mastrogippo/Prism-Test-Board/README.md

# Prism Test Board

[Writeup and pics here]( https://www.mastrogippo.it/2019/09/board-testing-its-fun-they-said/ )
