mastrogippo/Prism-Test-Board/HW/Board_seat.stl

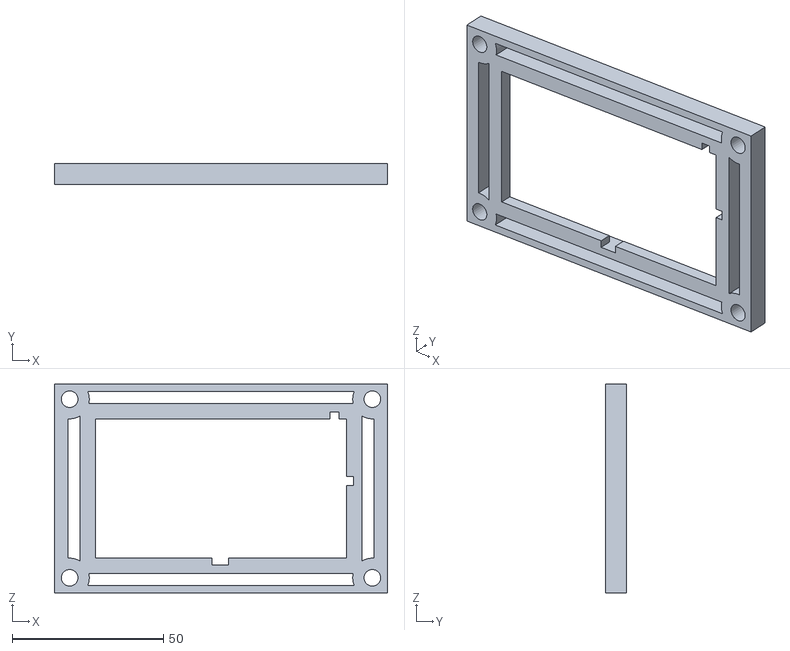
[picture p1: CAD file, 2019-09-27]
HW/Board_seat.stl
110.0 x 7.00 x 69.0
