mastrogippo/Prism-Test-Board/HW/PCB/test_board_logic3.brd

## EAGLE design HW/PCB/test_board_logic3.brd (2019-09-27)

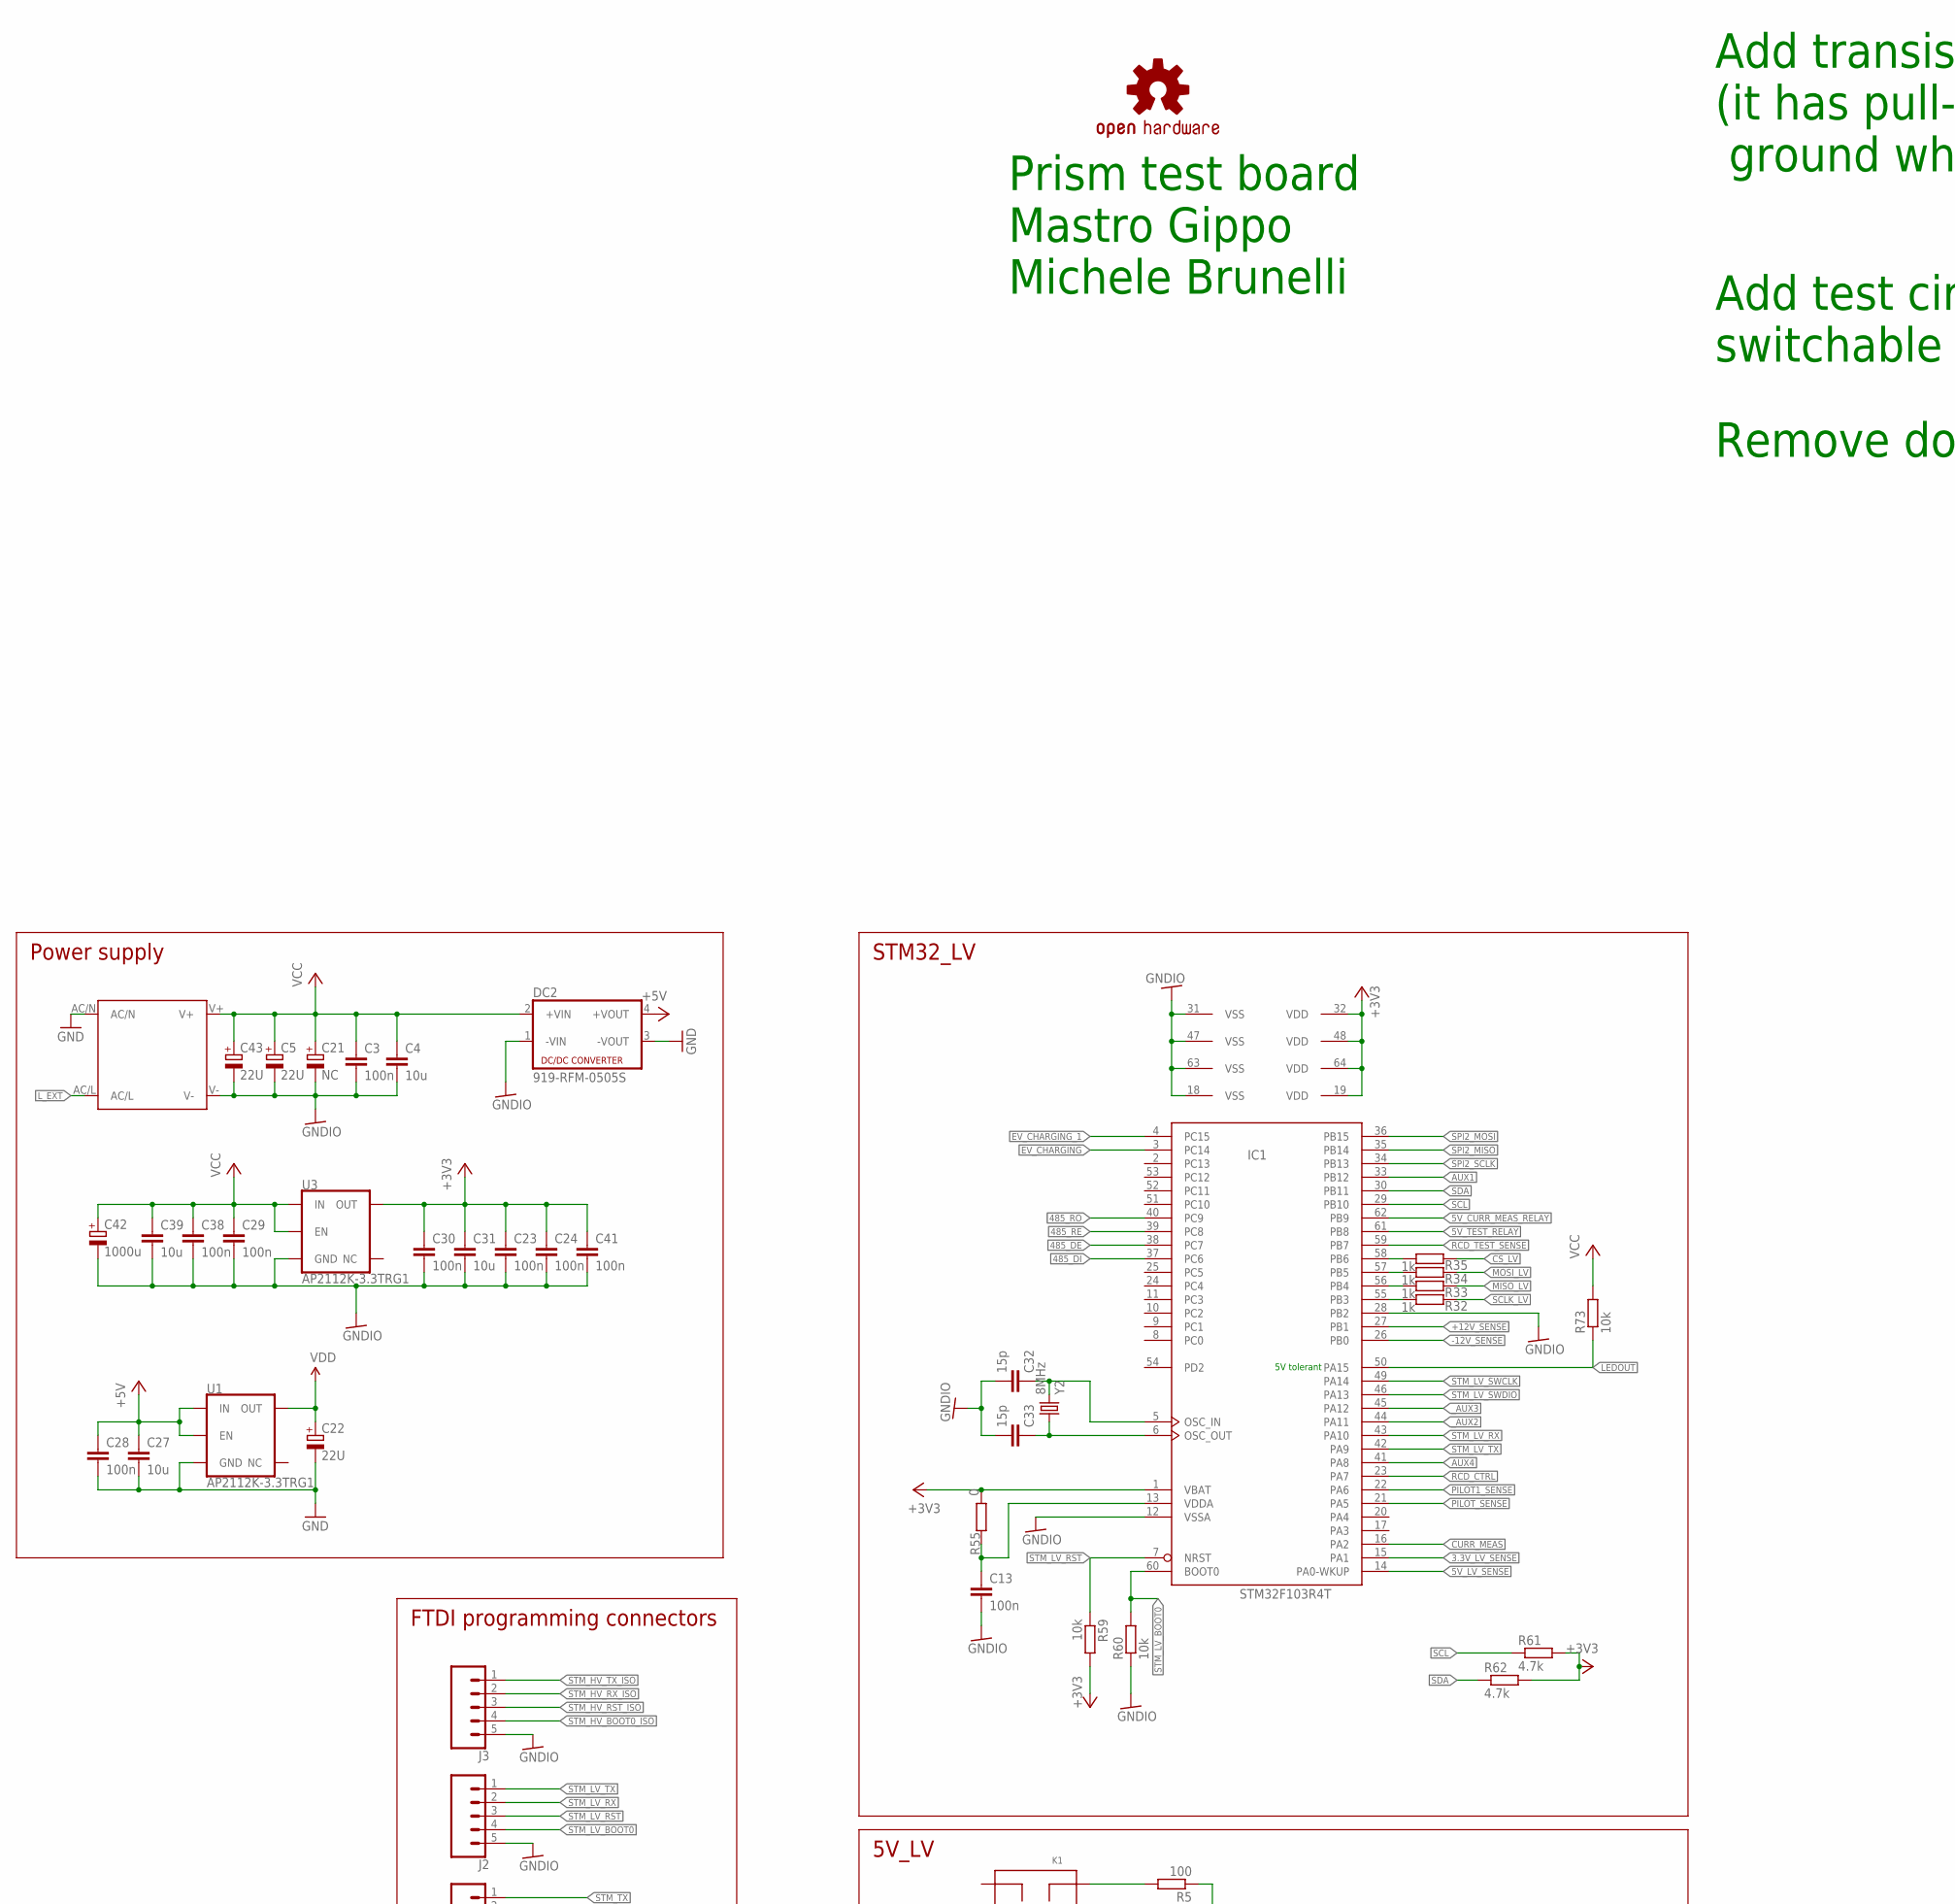
[picture p2: schematic test_board_logic3.sch, part in row 1, column 1]

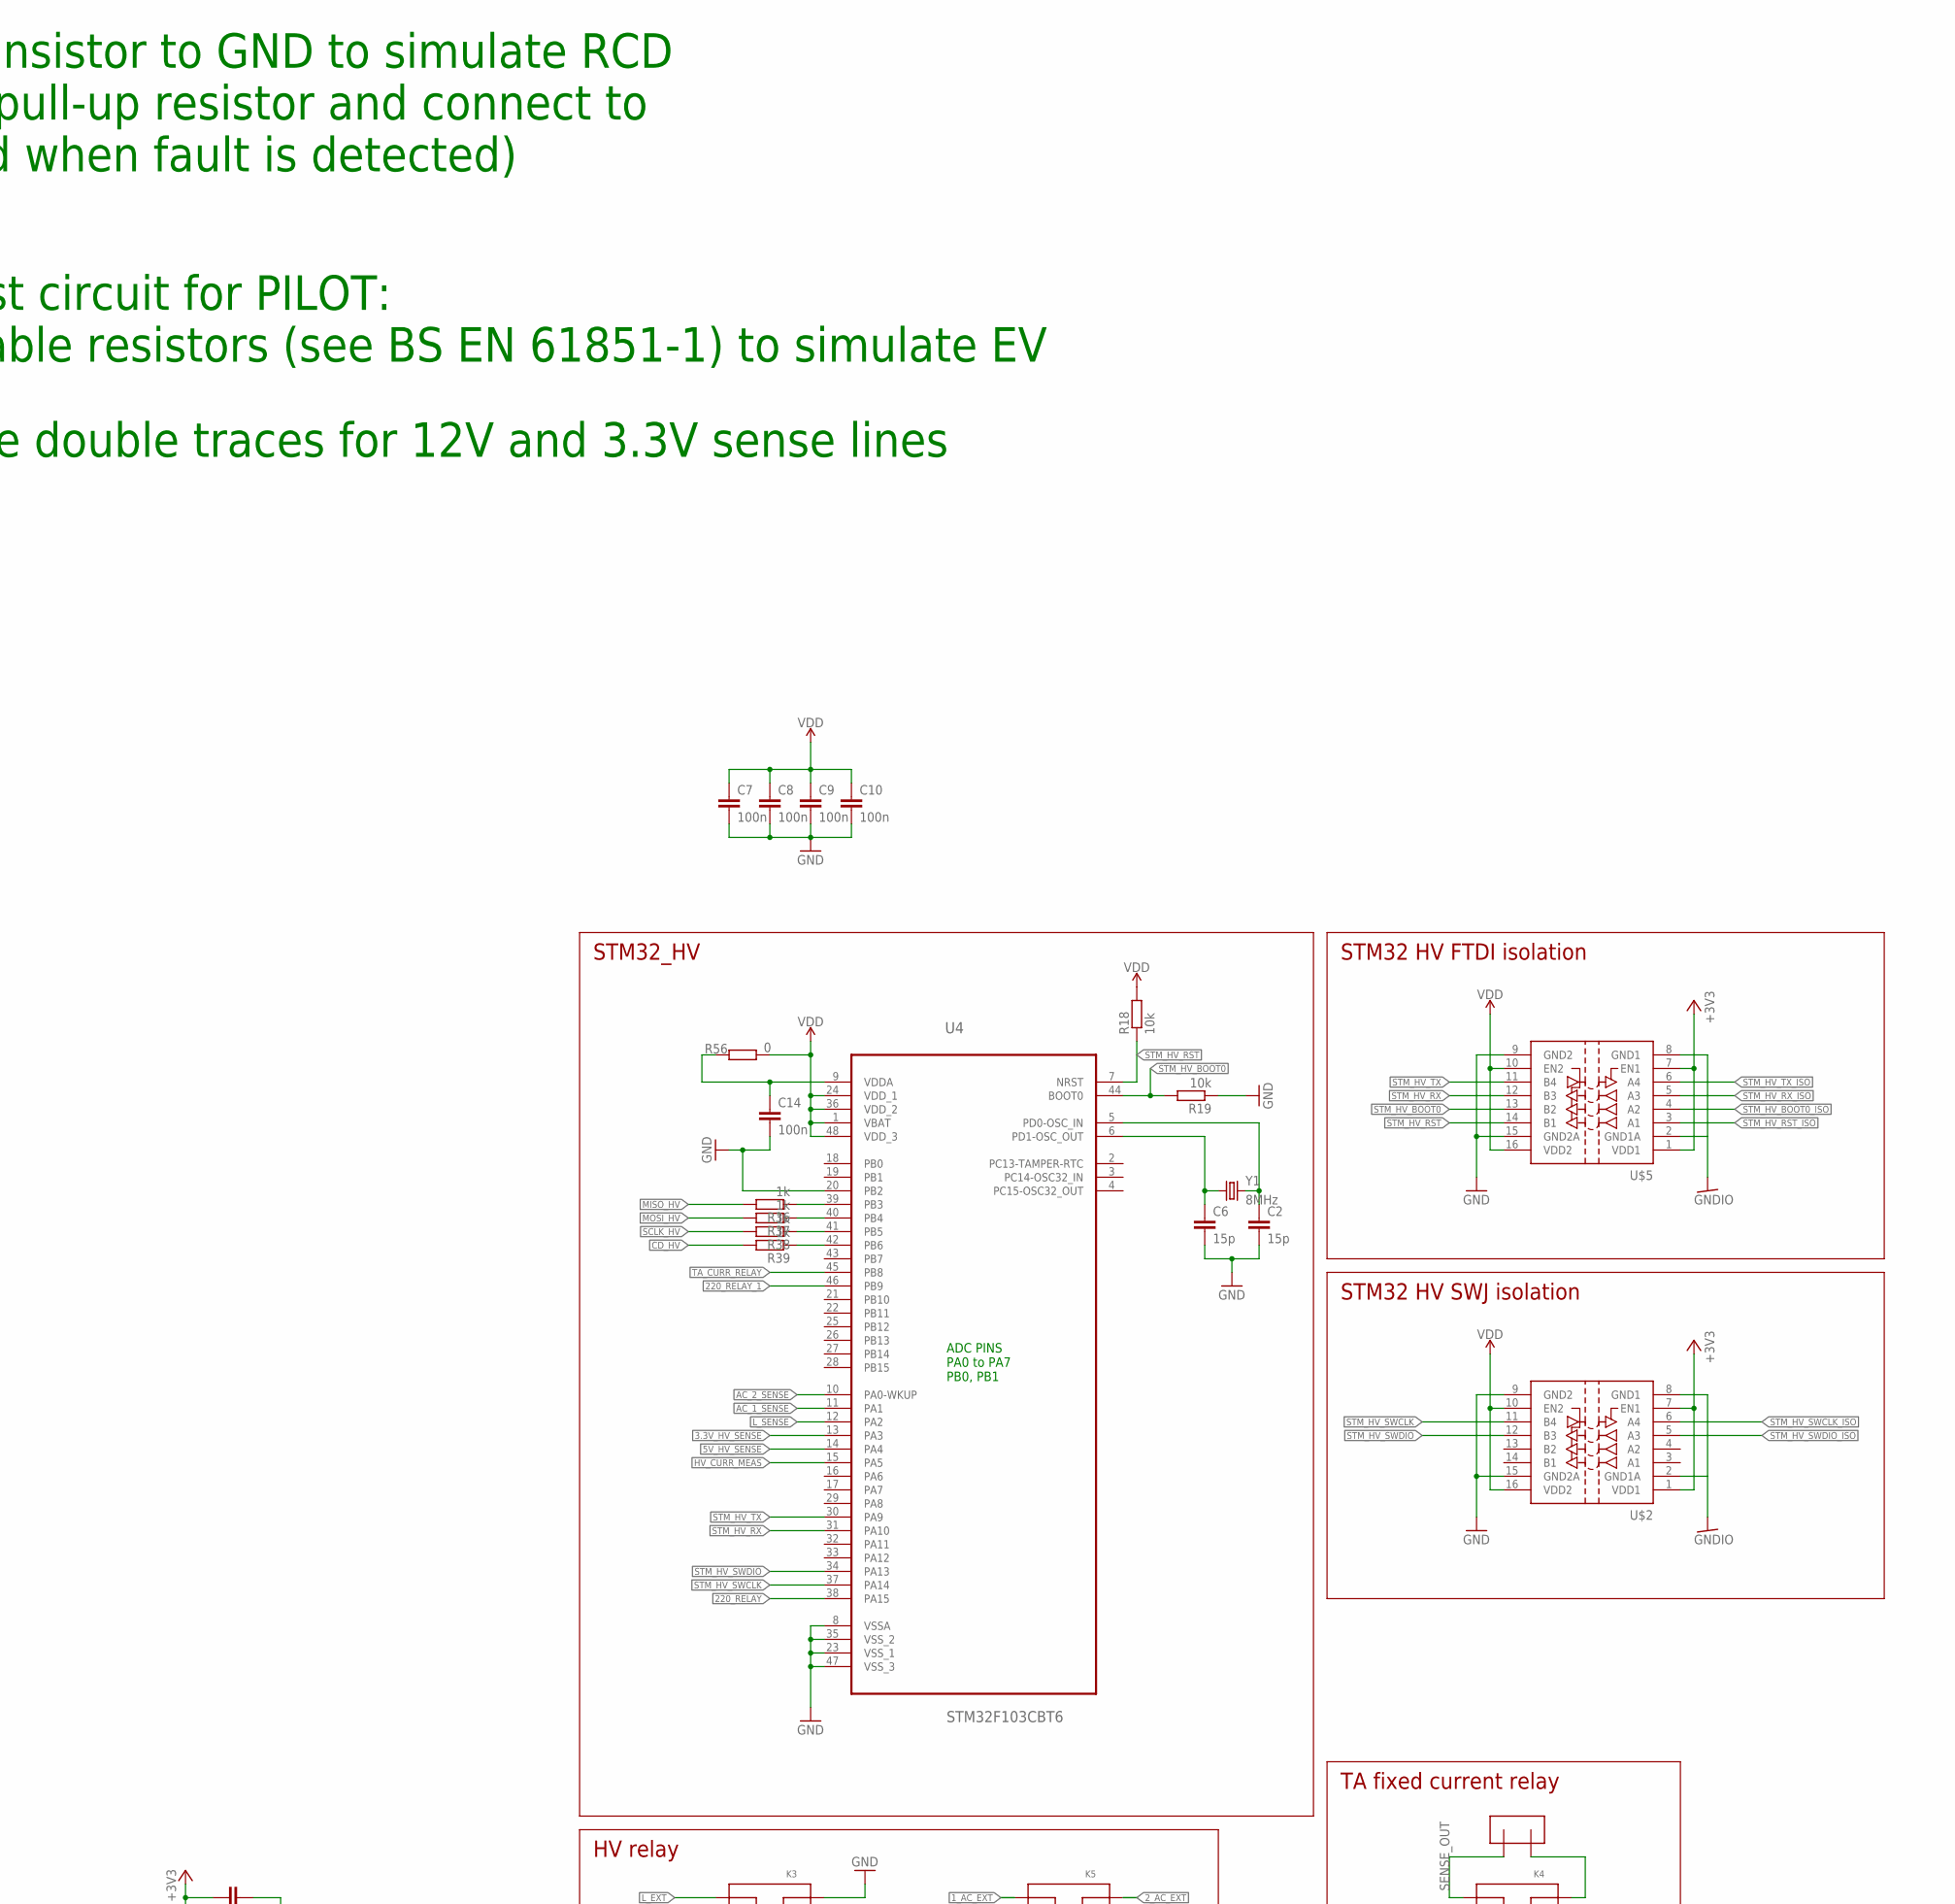
[picture p3: schematic test_board_logic3.sch, part in row 1, column 2]

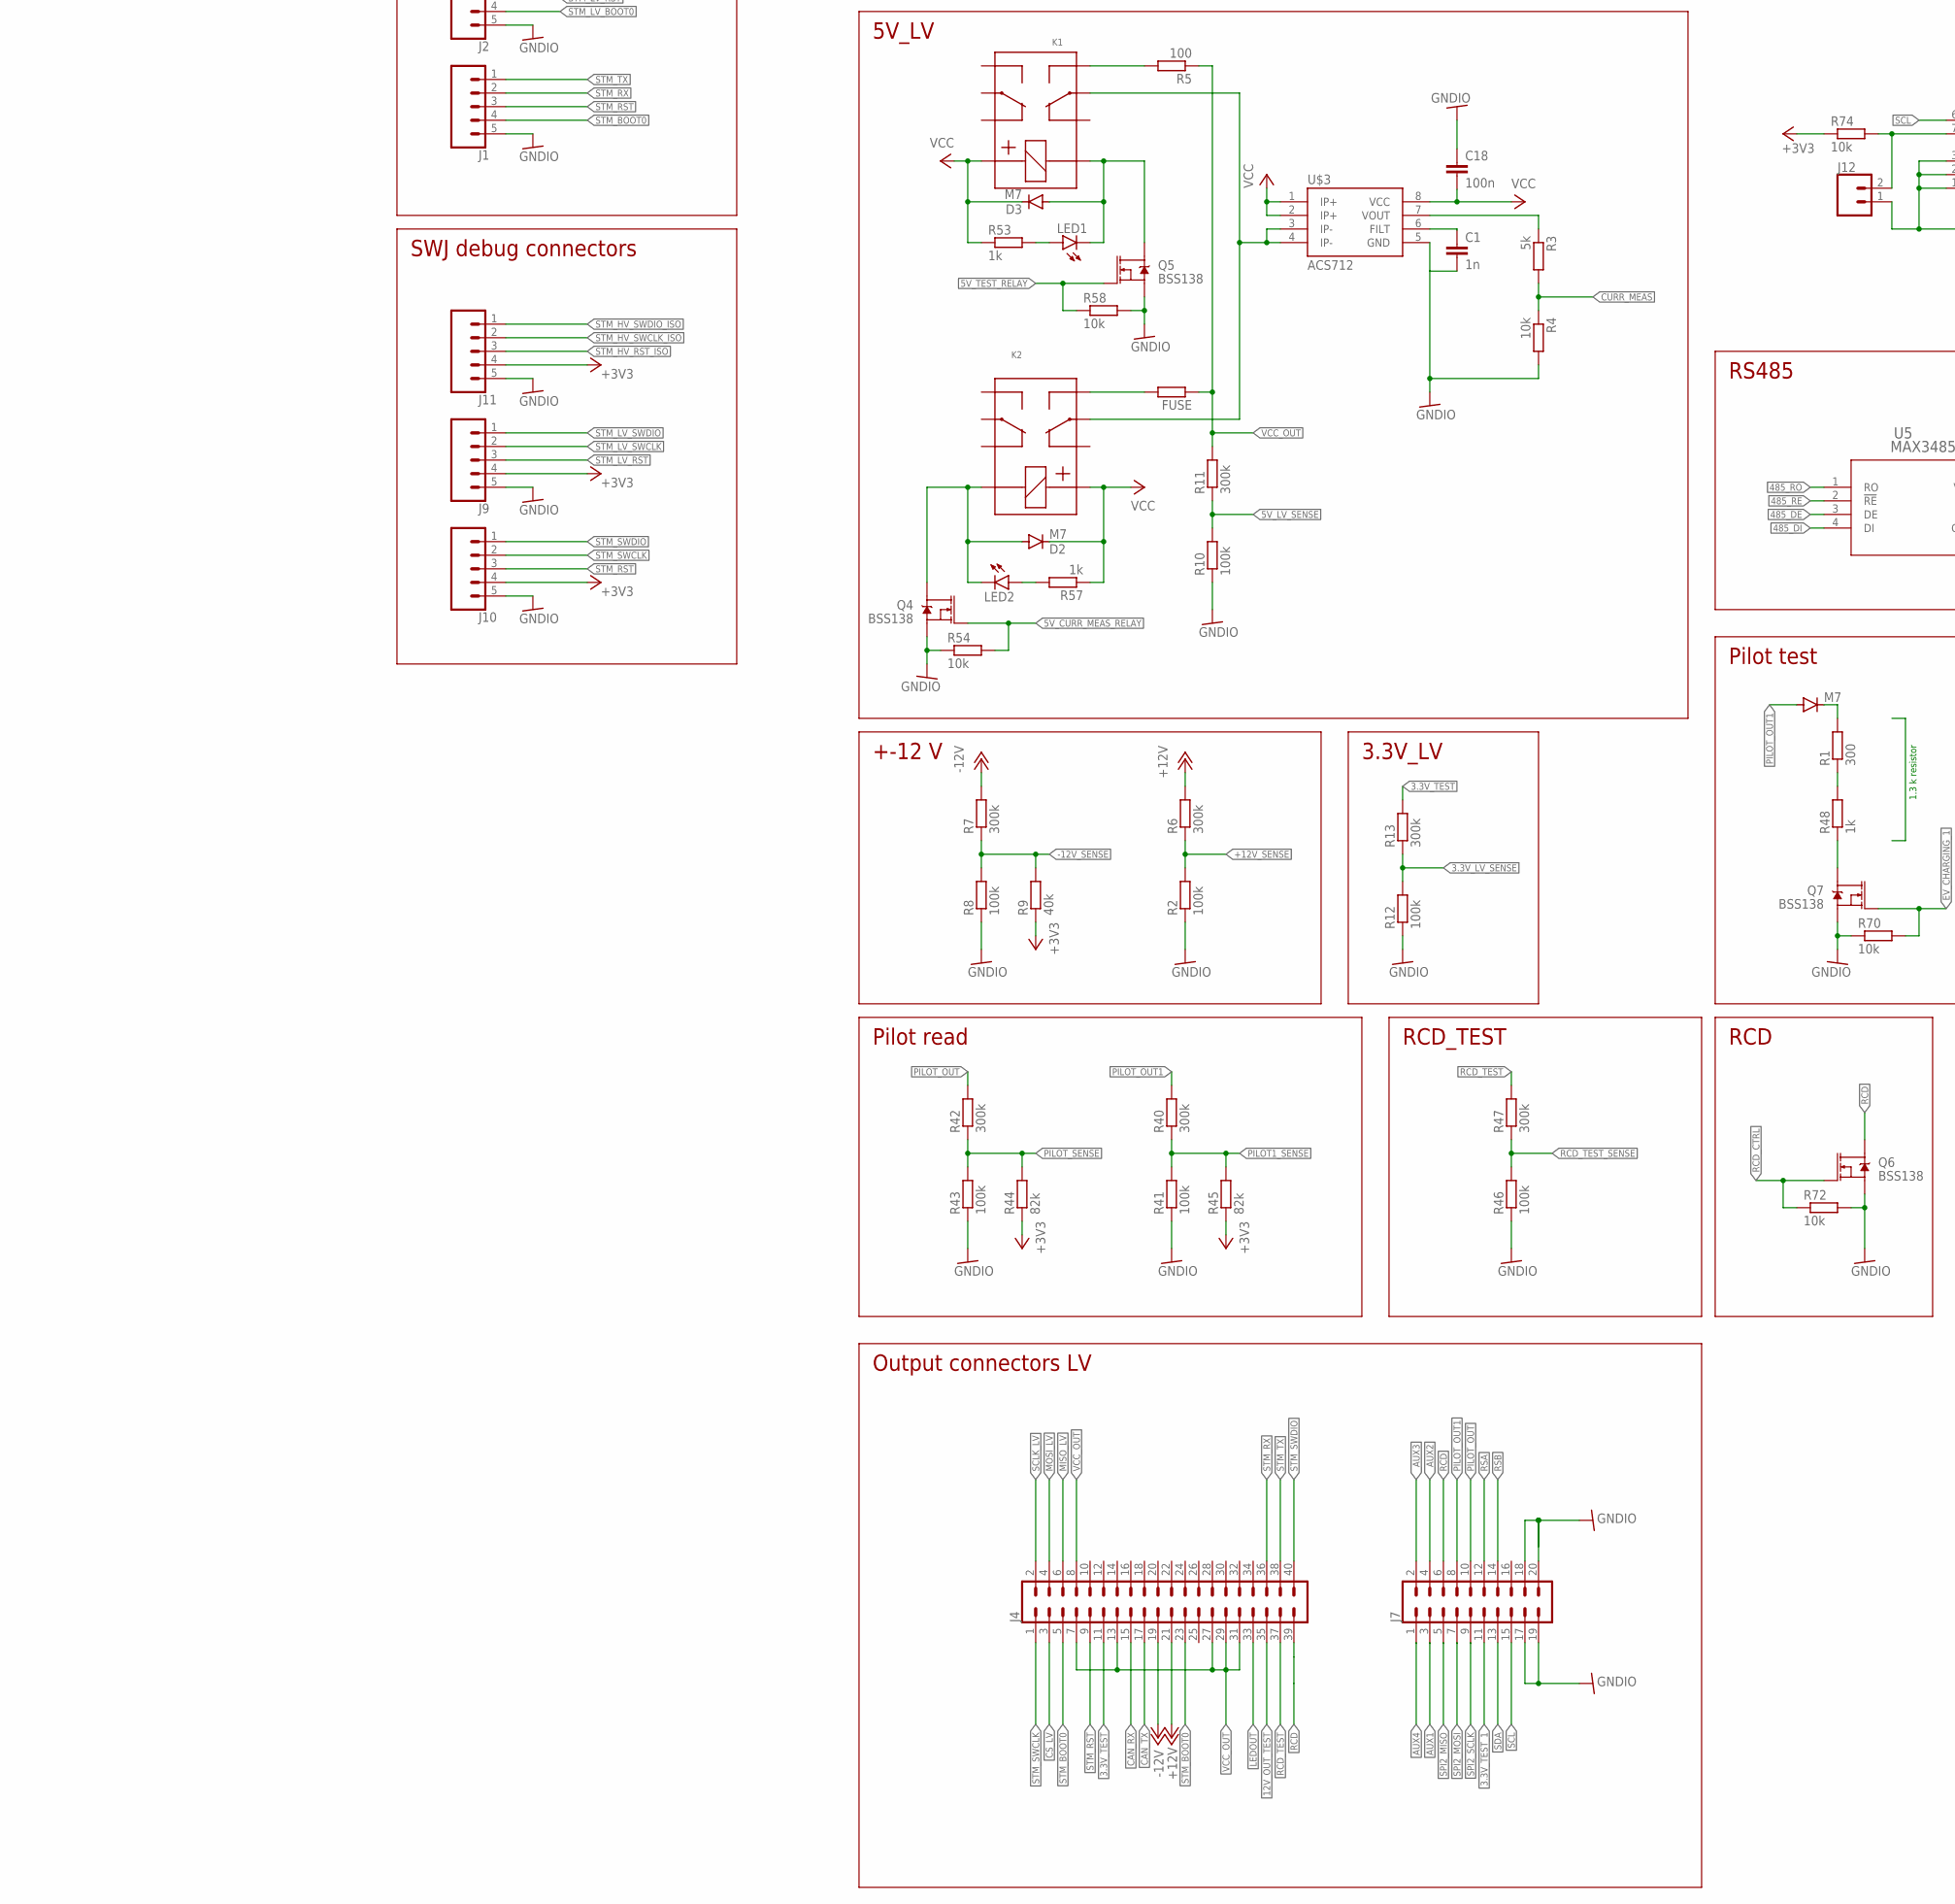
[picture p4: schematic test_board_logic3.sch, part in row 2, column 1]

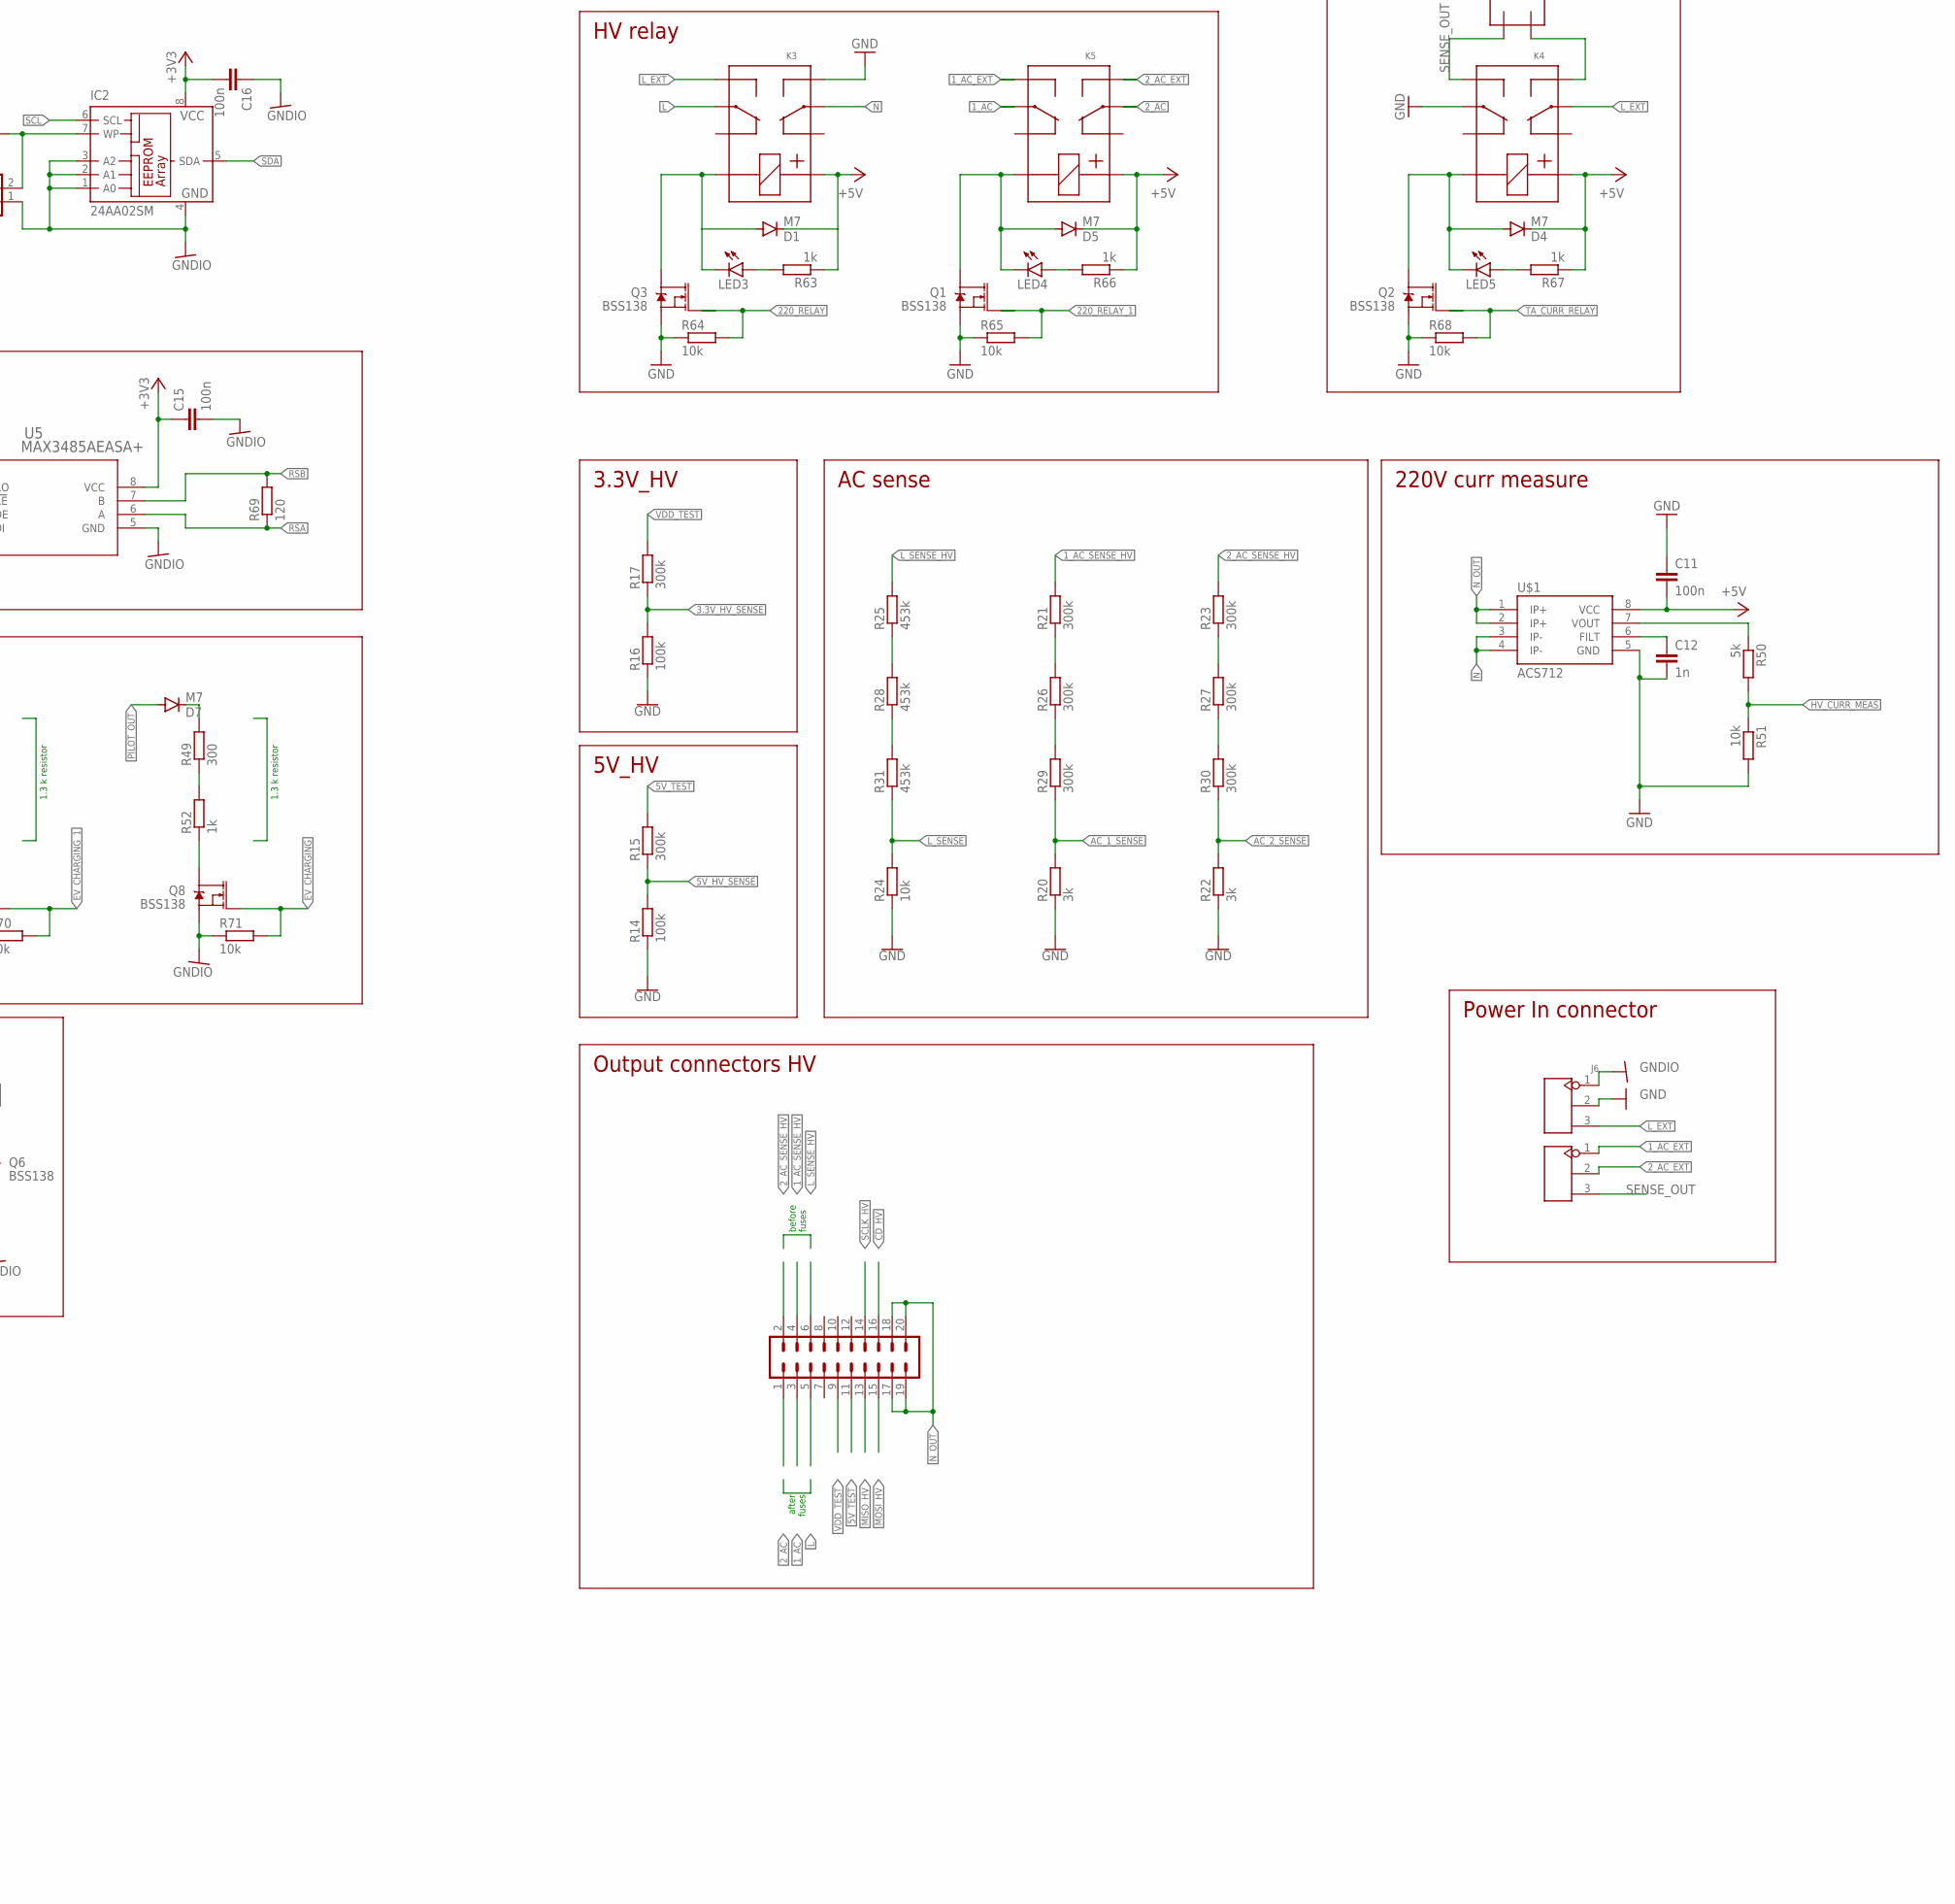
[picture p5: schematic test_board_logic3.sch, part in row 2, column 2]

Parts:
C1, C12: 1n; C0603K
C2, C6, C32, C33: 15p; C0603K
C3, C7, C8, C9, C10, C11, C13, C14, C15, C16, C18, C23, C24, C28, C29, C30, C38, C41: 100n; C0603K
C4, C27, C31, C39: 10u; C0805K
C5, C22, C43: 22U; B/3528-21R
C21: NC; 153CLV-0505
C42: 1000u; E5-10,5
D1, D2, D3, D4, D5, D6, D7: M7; DO-214AC
DC2: 919-RFM-0505S; NME
FUSE: R-EU_R0805; R0805
IC1: STM32F103R4T; LQFP64
IC2: 24AA02SM; SO-08M
J1, J2, J3, J9, J10, J11: 2001R-5P; JST-5-PTH-VERT
J4: CONN_20X2SHROUDED; 2X20_SHROUDED
J5, J6: GREEN-3P-5.0; H3-5.0-15.5X8.0MM
J7, J8: CONN_10X2; 2X10
J12: CONN_02; 1X02
K1, K2, K3, K4, K5: G6S-2
LED1, LED2, LED3, LED4, LED5: LEDSMT1206; 1206
Q1, Q2, Q3, Q4, Q5, Q6, Q7, Q8: BSS138; SOT23-3
R1, R49: 300; R0603
R2, R8, R10, R12, R14, R16, R41, R43, R46: 100k; R0603
R3, R50: 5k; R0603
R4, R18, R19, R24, R51, R54, R58, R59, R60, R64, R65, R68, R70, R71, R72, R73, R74: 10k; R0603
R5: 100; R1210
R6, R7, R11, R13, R15, R17, R21, R23, R26, R27, R29, R30, R40, R42, R47: 300k; R0603
R9: 40k; R0603
R20, R22: 3k; R0603
R25, R28, R31: 453k; R0603
R32, R33, R34, R35, R36, R37, R38, R39, R48, R52, R53, R57, R63, R66, R67: 1k; R0603
R44, R45: 82k; R0603
R55, R56: 0; R0603
R61, R62: 4.7k; R0603
R69: 120; R0603
U1, U3: AP2112K-3.3TRG1; SOT23-5
U4: STM32F103CBT6; QFP50P900X900X160-48N
U5: MAX3485AEASA+; 21-0041B_8
U$1, U$3: ACS712; SO08
U$2, U$5: SI8441IS1; SO16
U$4: NC; IRM_15/20
U$6: 2 PIN STRIP F; STRIP_NOMIDDLE
U$7: OSHW-LOGOL; OSHW-LOGO-L
Y1, Y2: 8MHz; CRYSTAL-SMD-3.2X2.5MM

Connections:
1_AC: J8.3, K5.9
1_AC1: R21.1, R26.2
1_AC2: R26.1, R29.2
1_AC_EXT: J5.1, K5.8
1_AC_SENSE_HV: J8.4, R21.2
2_AC: J8.1, K5.4
2_AC1: R23.1, R27.2
2_AC2: R27.1, R30.2
2_AC_EXT: J5.2, K5.5
2_AC_SENSE_HV: J8.2, R23.2
3.3V_HV_SENSE: R16.2, R17.1, U4.13 (PA3)
3.3V_LV_SENSE: IC1.15 (PA1), R12.2, R13.1
3.3V_TEST: J4.11, R13.2
3.3V_TEST_1: J7.11
5V_CURR_MEAS_RELAY: IC1.62 (PB9), Q4.1 (G), R54.2
5V_HV_SENSE: R14.2, R15.1, U4.14 (PA4)
5V_LV_SENSE: IC1.14 (PA0-WKUP), R10.2, R11.1
5V_TEST: J8.11, R15.2
5V_TEST_RELAY: IC1.61 (PB8), Q5.1 (G), R58.1
12V_OUT_TEST: J4.35
220_RELAY: Q3.1 (G), R64.2, U4.38 (PA15)
220_RELAY_1: Q1.1 (G), R65.2, U4.46 (PB9)
485_DE: IC1.38 (PC7), U5.3 (DE)
485_DI: IC1.37 (PC6), U5.4 (DI)
485_RE: IC1.39 (PC8), U5.2 (!RE)
485_RO: IC1.40 (PC9), U5.1 (RO)
+3V3: C15.1, C16.2, C23.1, C24.1, C30.1, C31.1, C41.1, IC1.1 (VBAT), IC1.19 (VDD), IC1.32 (VDD), IC1.48 (VDD), IC1.64 (VDD), IC2.8 (VCC), J9.4, J10.4, J11.4, R9.1, R44.1, R45.1, R55.1, R59.2, R61.2, R62.2, R74.1, U3.5 (OUT), U5.8 (VCC), U$2.1 (VDD1), U$2.7 (EN1), U$5.1 (VDD1), U$5.7 (EN1)
+5V: C11.2, C27.1, C28.1, D1.C, D4.C, D5.C, DC2.4 (+VOUT), K3.1, K4.1, K5.1, R63.1, R66.1, R67.1, U1.1 (IN), U1.3 (EN), U$1.8 (VCC)
+12V: J4.21, R6.2
+12V_SENSE: IC1.27 (PB1), R2.2, R6.1
-12V: J4.19, R7.2
-12V_SENSE: IC1.26 (PB0), R7.1, R8.2, R9.2
AC_1_SENSE: R20.2, R29.1, U4.11 (PA1)
AC_2_SENSE: R22.2, R30.1, U4.10 (PA0-WKUP)
AUX1: IC1.33 (PB12), J7.3
AUX4: IC1.41 (PA8), J7.1
CAN_RX: J4.15
CAN_TX: J4.17
CD_HV: J8.16, R39.2
CS_LV: J4.3, R35.2
CURR_MEAS: IC1.16 (PA2), R3.2, R4.1
EV_CHARGING: IC1.3 (PC14), Q8.1 (G), R71.2
EV_CHARGING_1: IC1.4 (PC15), Q7.1 (G), R70.2
GND: C2.2, C6.2, C7.2, C8.2, C9.2, C10.2, C11.1, C12.2, C14.2, C22.-, C27.2, C28.2, DC2.3 (-VOUT), J6.2, K3.5, K4.9, Q1.2 (S), Q2.2 (S), Q3.2 (S), R14.1, R16.1, R19.1, R20.1, R22.1, R24.1, R51.2, R64.1, R65.1, R68.1, U1.2 (GND), U4.8 (VSSA), U4.20 (PB2), U4.23 (VSS_1), U4.35 (VSS_2), U4.47 (VSS_3), U$1.5 (GND), U$2.9 (GND2), U$2.15 (GND2A), U$4.AC/N, U$5.9 (GND2), U$5.15 (GND2A)
GNDIO: C1.2, C3.2, C4.2, C5.-, C13.2, C15.2, C16.1, C18.1, C21.-, C23.2, C24.2, C29.2, C30.2, C31.2, C32.2, C33.2, C38.2, C39.2, C41.2, C42.-, C43.-, DC2.1 (-VIN), IC1.12 (VSSA), IC1.18 (VSS), IC1.28 (PB2), IC1.31 (VSS), IC1.47 (VSS), IC1.63 (VSS), IC2.1 (A0), IC2.2 (A1), IC2.3 (A2), IC2.4 (GND), J1.5, J2.5, J3.5, J6.1, J7.17, J7.18, J7.19, J7.20, J9.5, J10.5, J11.5, J12.1, Q4.2 (S), Q5.2 (S), Q6.2 (S), Q7.2 (S), Q8.2 (S), R2.1, R4.2, R8.1, R10.1, R12.1, R41.1, R43.1, R46.1, R54.1, R58.2, R60.1, R70.1, R71.1, R72.2, U3.2 (GND), U5.5 (GND), U$2.2 (GND1A), U$2.8 (GND1), U$3.5 (GND), U$4.V-, U$5.2 (GND1A), U$5.8 (GND1)
HV_CURR_MEAS: R50.2, R51.1, U4.15 (PA5)
L: J8.5, K3.9
L1: R25.1, R28.2
L2: R28.1, R31.2
LEDOUT: IC1.50 (PA15), J4.33, R73.1
L_EXT: J6.3, K3.8, K4.4, U$4.AC/L
L_SENSE: R24.2, R31.1, U4.12 (PA2)
L_SENSE_HV: J8.6, R25.2
MISO_HV: J8.13, R36.2
MISO_LV: J4.6, R33.2
MOSI_HV: J8.15, R37.2
MOSI_LV: J4.4, R34.2
N: K3.4, U$1.3 (IP-), U$1.4 (IP-)
unnamed: R3.1, U$3.7 (VOUT)
unnamed: FUSE.2, K2.5
unnamed: IC2.7 (WP), J12.2, R74.2
unnamed: C2.1, U4.5 (PD0-OSC_IN), Y1.3 (2)
unnamed: C1.1, U$3.6 (FILT)
unnamed: IC1.55 (PB3), R32.1
unnamed: C6.1, U4.6 (PD1-OSC_OUT), Y1.1
unnamed: K1.8, R5.2
unnamed: IC1.56 (PB4), R33.1
unnamed: K1.9, K2.4, U$3.3 (IP-), U$3.4 (IP-)
unnamed: C33.1, IC1.6 (OSC_OUT), Y2.1
unnamed: IC1.57 (PB5), R34.1
unnamed: IC1.58 (PB6), R35.1
unnamed: R36.1, U4.39 (PB3)
unnamed: R37.1, U4.40 (PB4)
unnamed: R38.1, U4.41 (PB5)
unnamed: R39.1, U4.42 (PB6)
unnamed: C12.1, U$1.6 (FILT)
unnamed: D4.A, K4.12, LED5.C, Q2.3 (D)
unnamed: R50.1, U$1.7 (VOUT)
unnamed: K4.5, U$6.P$1
unnamed: D1.A, K3.12, LED3.C, Q3.3 (D)
unnamed: D5.A, K5.12, LED4.C, Q1.3 (D)
unnamed: D2.A, K2.12, LED2.C, Q4.3 (D)
unnamed: D3.A, K1.12, LED1.C, Q5.3 (D)
unnamed: C13.1, IC1.13 (VDDA), R55.2
unnamed: C14.1, R56.2, U4.9 (VDDA)
unnamed: D6.C, R1.2
unnamed: Q7.3 (D), R48.1
unnamed: R49.1, R52.2
unnamed: Q8.3 (D), R52.1
unnamed: R1.1, R48.2
unnamed: LED1.A, R53.2
unnamed: LED5.A, R67.2
unnamed: LED2.A, R57.2
unnamed: LED3.A, R63.2
unnamed: LED4.A, R66.2
unnamed: D7.C, R49.2
unnamed: C32.1, IC1.5 (OSC_IN), Y2.3 (2)
N_OUT: J8.17, J8.18, J8.19, J8.20, U$1.1 (IP+), U$1.2 (IP+)
PA11: U4.32 (PA11)
PILOT1_SENSE: IC1.22 (PA6), R40.1, R41.2, R45.2
PILOT_OUT: D7.A, J7.10, R42.2
PILOT_OUT1: D6.A, J7.8, R40.2
PILOT_SENSE: IC1.21 (PA5), R42.1, R43.2, R44.2
RCD: J4.39, J7.6, Q6.3 (D)
RCD_CTRL: IC1.23 (PA7), Q6.1 (G), R72.1
RCD_TEST: J4.37, R47.2
RCD_TEST_SENSE: IC1.59 (PB7), R46.2, R47.1
RSA: J7.12, R69.1, U5.6 (A)
RSB: J7.14, R69.2, U5.7 (B)
SCL: IC1.29 (PB10), IC2.6 (SCL), J7.15, R61.1
SCLK_HV: J8.14, R38.2
SCLK_LV: J4.2, R32.2
SDA: IC1.30 (PB11), IC2.5 (SDA), J7.13, R62.1
SENSE_OUT: J5.3, K4.8, U$6.P$2
SPI2_MISO: IC1.35 (PB14), J7.5
SPI2_MOSI: IC1.36 (PB15), J7.7
SPI2_SCLK: IC1.34 (PB13), J7.9
STM_BOOT0: J1.4, J4.5, J4.23
STM_HV_BOOT0: R19.2, U4.44 (BOOT0), U$5.13 (B2)
STM_HV_BOOT0_ISO: J3.4, U$5.4 (A2)
STM_HV_RST: R18.1, U4.7 (NRST), U$5.14 (B1)
STM_HV_RST_ISO: J3.3, J11.3, U$5.3 (A1)
STM_HV_RX: U4.31 (PA10), U$5.12 (B3)
STM_HV_RX_ISO: J3.2, U$5.5 (A3)
STM_HV_SWCLK: U4.37 (PA14), U$2.11 (B4)
STM_HV_SWCLK_ISO: J11.2, U$2.6 (A4)
STM_HV_SWDIO: U4.34 (PA13), U$2.12 (B3)
STM_HV_SWDIO_ISO: J11.1, U$2.5 (A3)
STM_HV_TX: U4.30 (PA9), U$5.11 (B4)
STM_HV_TX_ISO: J3.1, U$5.6 (A4)
STM_LV_BOOT0: IC1.60 (BOOT0), J2.4, R60.2
STM_LV_RST: IC1.7 (NRST), J2.3, J9.3, R59.1
STM_LV_RX: IC1.43 (PA10), J2.2
STM_LV_SWCLK: IC1.49 (PA14), J9.2
STM_LV_SWDIO: IC1.46 (PA13), J9.1
STM_LV_TX: IC1.42 (PA9), J2.1
STM_RST: J1.3, J4.9, J10.3
STM_RX: J1.2, J4.36
STM_SWCLK: J4.1, J10.2
STM_SWDIO: J4.40, J10.1
STM_TX: J1.1, J4.38
TA_CURR_RELAY: Q2.1 (G), R68.2, U4.45 (PB8)
VCC: C3.1, C4.1, C5.+, C18.2, C21.+, C29.1, C38.1, C39.1, C42.+, C43.+, D2.C, D3.C, DC2.2 (+VIN), K1.1, K2.1, R53.1, R57.1, R73.2, U3.1 (IN), U3.3 (EN), U$3.1 (IP+), U$3.2 (IP+), U$3.8 (VCC), U$4.V+
VCC_OUT: FUSE.1, J4.7, J4.8, J4.13, J4.27, J4.29, J4.31, R5.1, R11.2
VDD: C7.1, C8.1, C9.1, C10.1, C22.+, R18.2, R56.1, U1.5 (OUT), U4.1 (VBAT), U4.24 (VDD_1), U4.36 (VDD_2), U4.48 (VDD_3), U$2.10 (EN2), U$2.16 (VDD2), U$5.10 (EN2), U$5.16 (VDD2)
VDD_TEST: J8.9, R17.2
_AUX2: IC1.44 (PA11), J7.4
_AUX3: IC1.45 (PA12), J7.2

Notes on the sheet:
+-12 V
5V_LV
Power supply
3.3V_LV
5V_HV
3.3V_HV
STM32_LV
STM32_HV
AC sense
HV relay
Pilot read
Output connectors LV
Output connectors HV
before fuses
after fuses
RCD_TEST
FTDI programming connectors
STM32 HV FTDI isolation
220V curr measure
TA fixed current relay
STM32 HV SWJ isolation
SWJ debug connectors
Power In connector
ADC PINS PA0 to PA7 PB0, PB1
Add transistor to GND to simulate RCD (it has pull-up resistor and connect to ground when fault is detected)
Add test circuit for PILOT: switchable resistors (see BS EN 61851-1) to simulate EV
Remove double traces for 12V and 3.3V sense lines
RCD
1.3 k resistor
Pilot test
RS485
5V tolerant
Prism test board Mastro Gippo Michele Brunelli

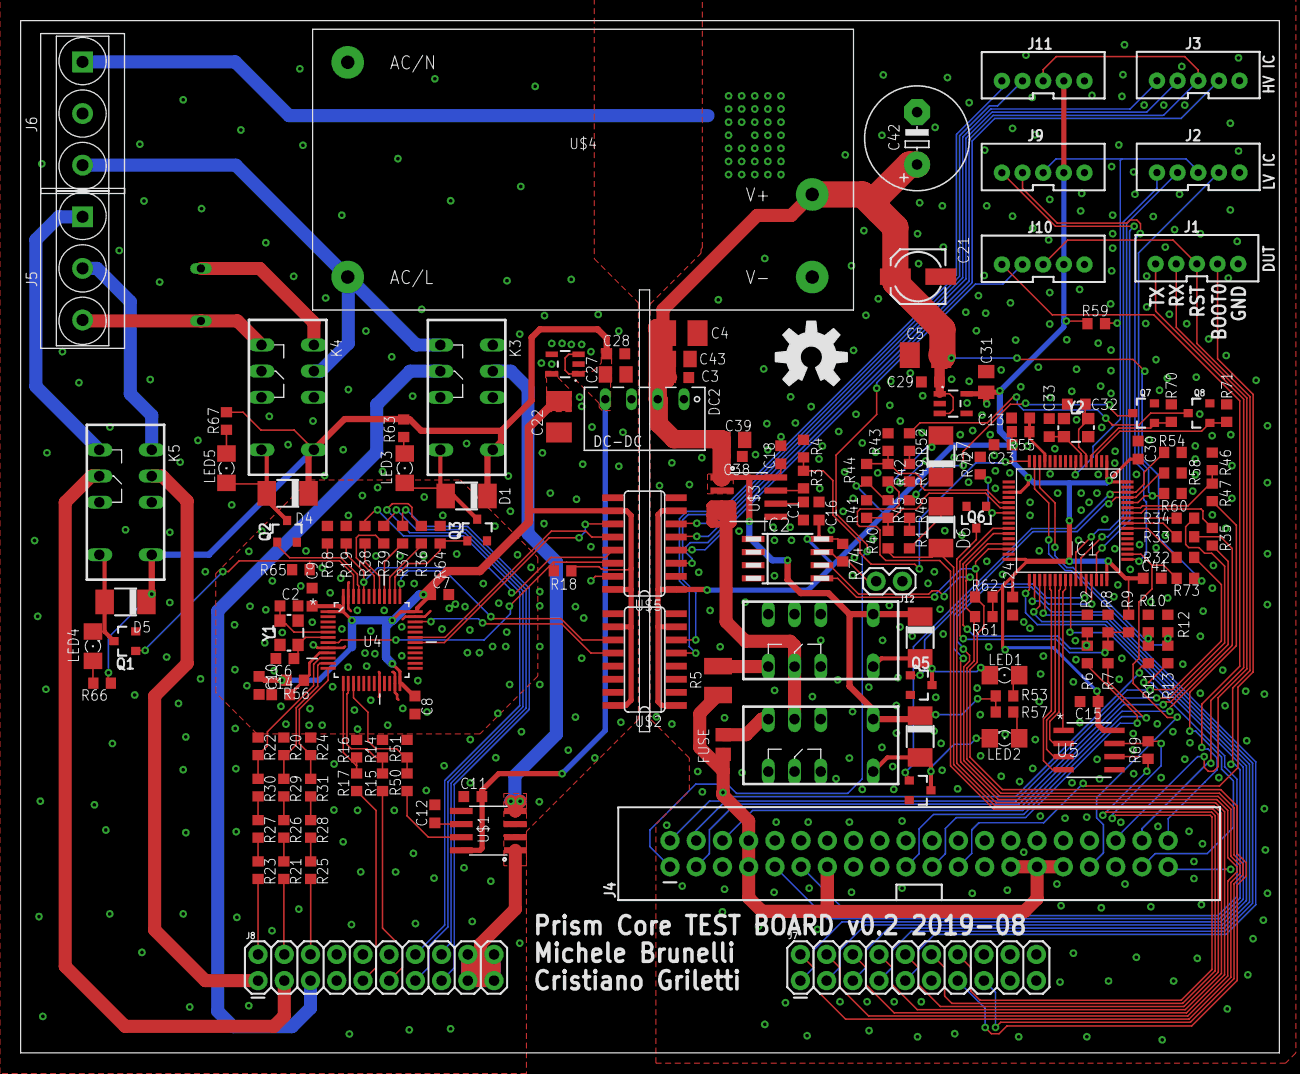
[picture p6: board test_board_logic3.brd from above]

Board: 2 copper layers, 121.9 x 100.0 mm, 161 parts (0 on the bottom side), 143 nets.
