mastrogippo/Prism-Test-Board/HW/PCB/test_board.brd

## EAGLE design HW/PCB/test_board.brd (2019-09-27)

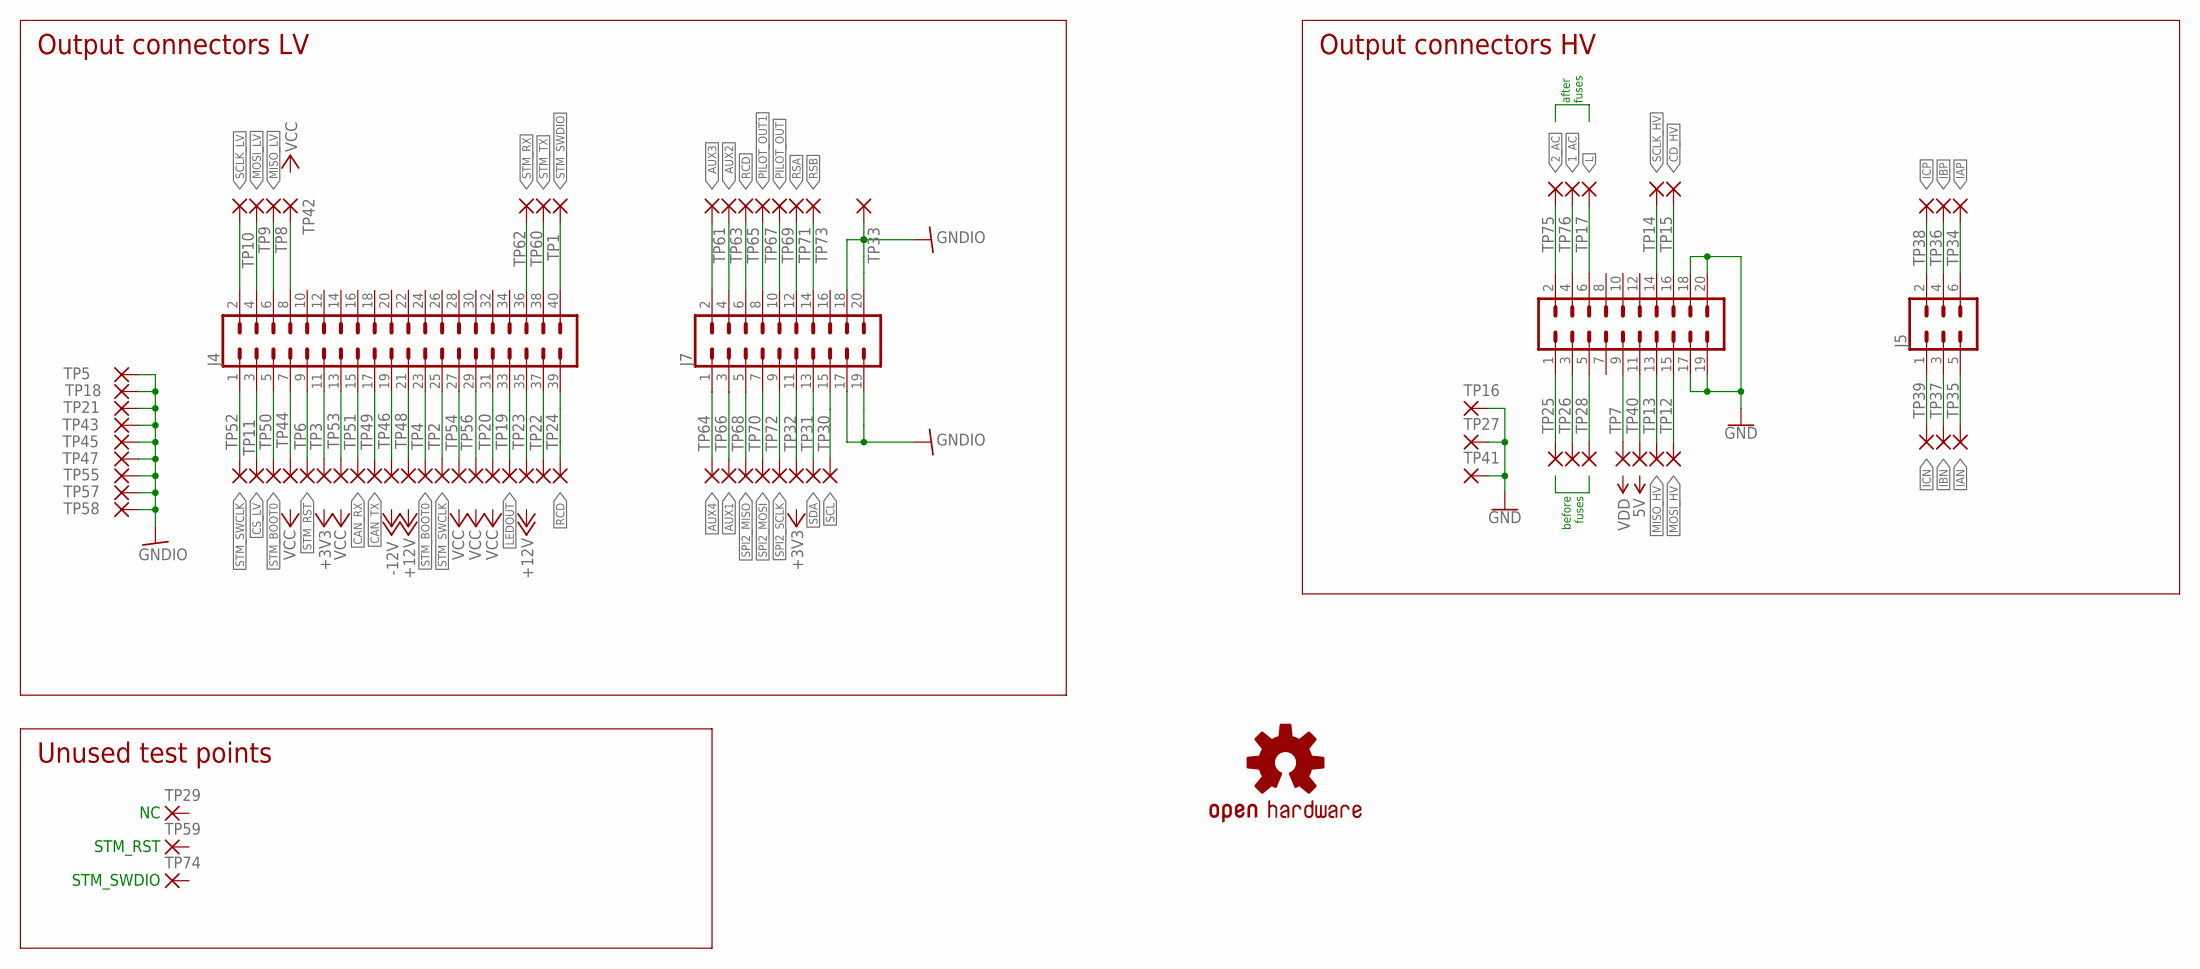
[picture p7: schematic test_board.sch]

Parts:
J4: CONN_20X2SHROUDED; 2X20_SHROUDED
J5: CONN_03X2SHROUD; 2X3-SHROUDED
J7, J8: CONN_10X2; 2X10
TP1, TP3, TP4, TP6, TP7, TP12, TP13, TP16, TP17, TP25, TP26, TP27, TP28, TP49, TP50, TP51, TP52, TP53, TP54, TP55, TP56, TP57, TP58, TP59, TP60, TP61, TP62, TP63, TP64, TP65, TP66, TP67, TP68, TP69, TP70, TP71, TP72, TP73, TP74, TP75, TP76: 1.35_HOLEROUND; 2,2/1,35_ROUND
TP2, TP8, TP9, TP10, TP14, TP15: 1.35_HOLEOFFSET; 1,7/1,35_OFFSET
TP5, TP11, TP18, TP19, TP20, TP21, TP22, TP23, TP24, TP29, TP30, TP31, TP32, TP33, TP34, TP35, TP36, TP37, TP38, TP39, TP40, TP41, TP42, TP43, TP44, TP45, TP46, TP47, TP48: 1.35_HOLELONG; 1,7/1,35_LONG
U$1: OSHW-LOGOL; OSHW-LOGO-L

Connections:
1_AC: J8.4, TP76.1
2_AC: J8.2, TP75.1
AUX1: J7.3, TP66.1
AUX4: J7.1, TP64.1
CAN_RX: J4.15, TP51.1
CAN_TX: J4.17, TP49.1
CD_HV: J8.16, TP15.1
CS_LV: J4.3, TP11.1
GND: J8.17, J8.18, J8.19, J8.20, TP16.1, TP27.1, TP41.1
GNDIO: J7.17, J7.18, J7.19, J7.20, TP5.1, TP18.1, TP21.1, TP33.1, TP43.1, TP45.1, TP47.1, TP55.1, TP57.1, TP58.1
IAN: J5.5, TP35.1
IAP: J5.6, TP34.1
IBN: J5.3, TP37.1
IBP: J5.4, TP36.1
ICN: J5.1, TP39.1
ICP: J5.2, TP38.1
L: J8.6, TP17.1
LEDOUT: J4.33, TP19.1
MISO_HV: J8.13, TP13.1
MISO_LV: J4.6, TP8.1
MOSI_HV: J8.15, TP12.1
MOSI_LV: J4.4, TP9.1
unnamed: J4.31, TP20.1
unnamed: J7.11, TP32.1
unnamed: J4.8, TP42.1
unnamed: J4.37, TP22.1
unnamed: J4.29, TP56.1
unnamed: J8.11, TP40.1
unnamed: J8.9, TP7.1
unnamed: J4.27, TP54.1
unnamed: J4.11, TP3.1
unnamed: J4.13, TP53.1
unnamed: J4.35, TP23.1
unnamed: J4.19, TP46.1
unnamed: J4.21, TP48.1
unnamed: J4.7, TP44.1
unnamed: J8.1, TP25.1
unnamed: J8.3, TP26.1
unnamed: J8.5, TP28.1
PILOT_OUT: J7.10, TP69.1
PILOT_OUT1: J7.8, TP67.1
RCD: J4.39, J7.6, TP24.1, TP65.1
RSA: J7.12, TP71.1
RSB: J7.14, TP73.1
SCL: J7.15, TP30.1
SCLK_HV: J8.14, TP14.1
SCLK_LV: J4.2, TP10.1
SDA: J7.13, TP31.1
SPI2_MISO: J7.5, TP68.1
SPI2_MOSI: J7.7, TP70.1
SPI2_SCLK: J7.9, TP72.1
STM_BOOT0: J4.5, J4.23, TP4.1, TP50.1
STM_RST: J4.9, TP6.1
STM_RX: J4.36, TP62.1
STM_SWCLK: J4.1, J4.25, TP2.1, TP52.1
STM_SWDIO: J4.40, TP1.1
STM_TX: J4.38, TP60.1
_AUX2: J7.4, TP63.1
_AUX3: J7.2, TP61.1

Notes on the sheet:
Output connectors LV
STM_SWDIO
STM_RST
Unused test points
Output connectors HV
after fuses
before fuses

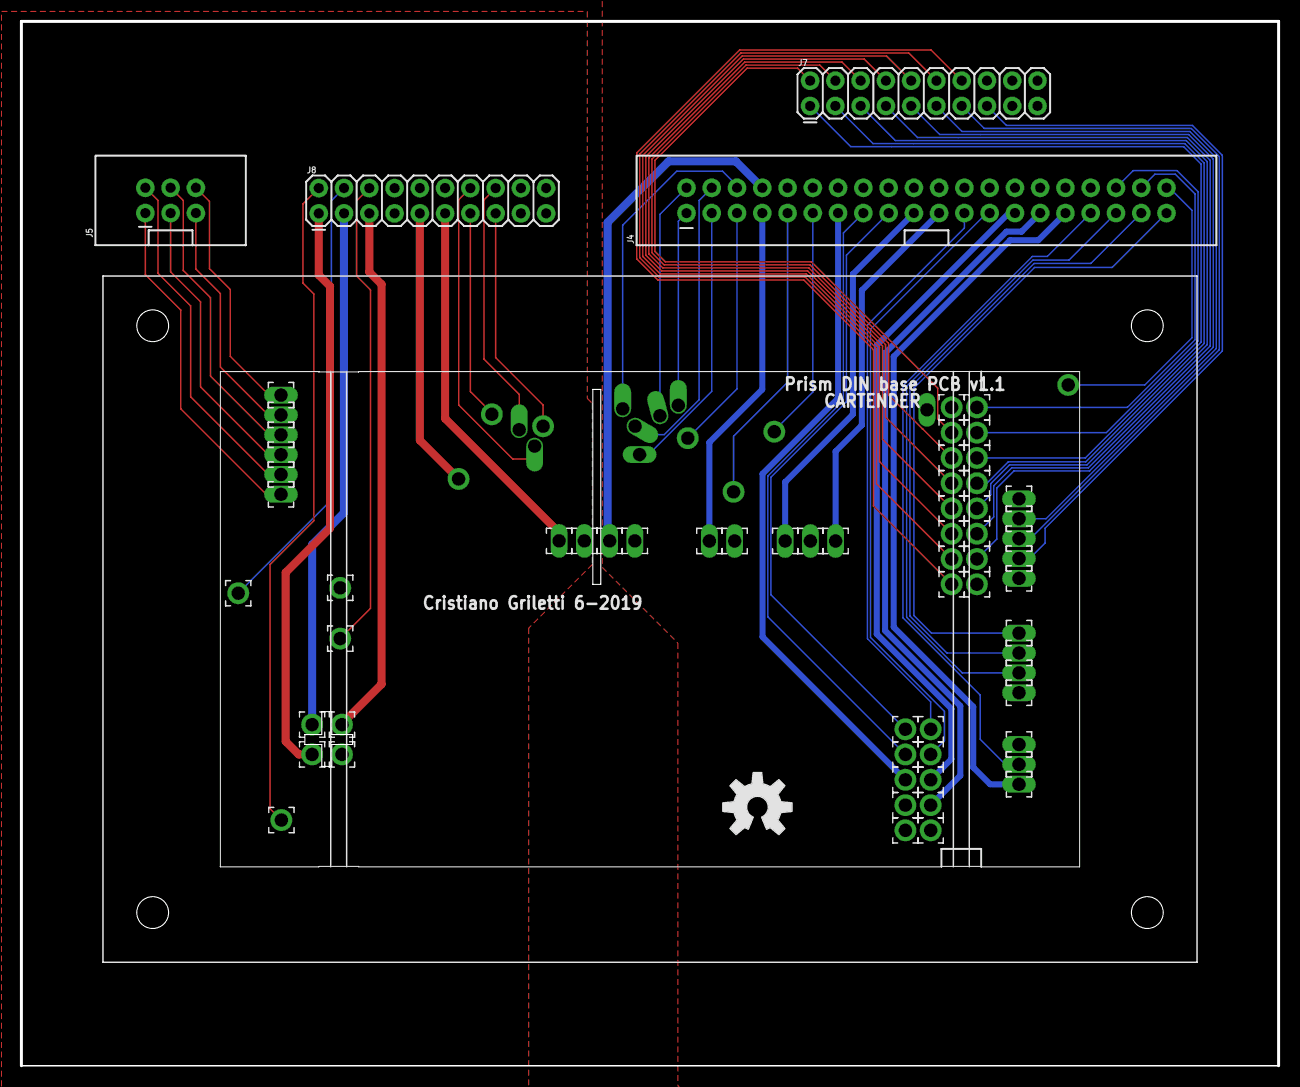
[picture p8: board test_board.brd from above]

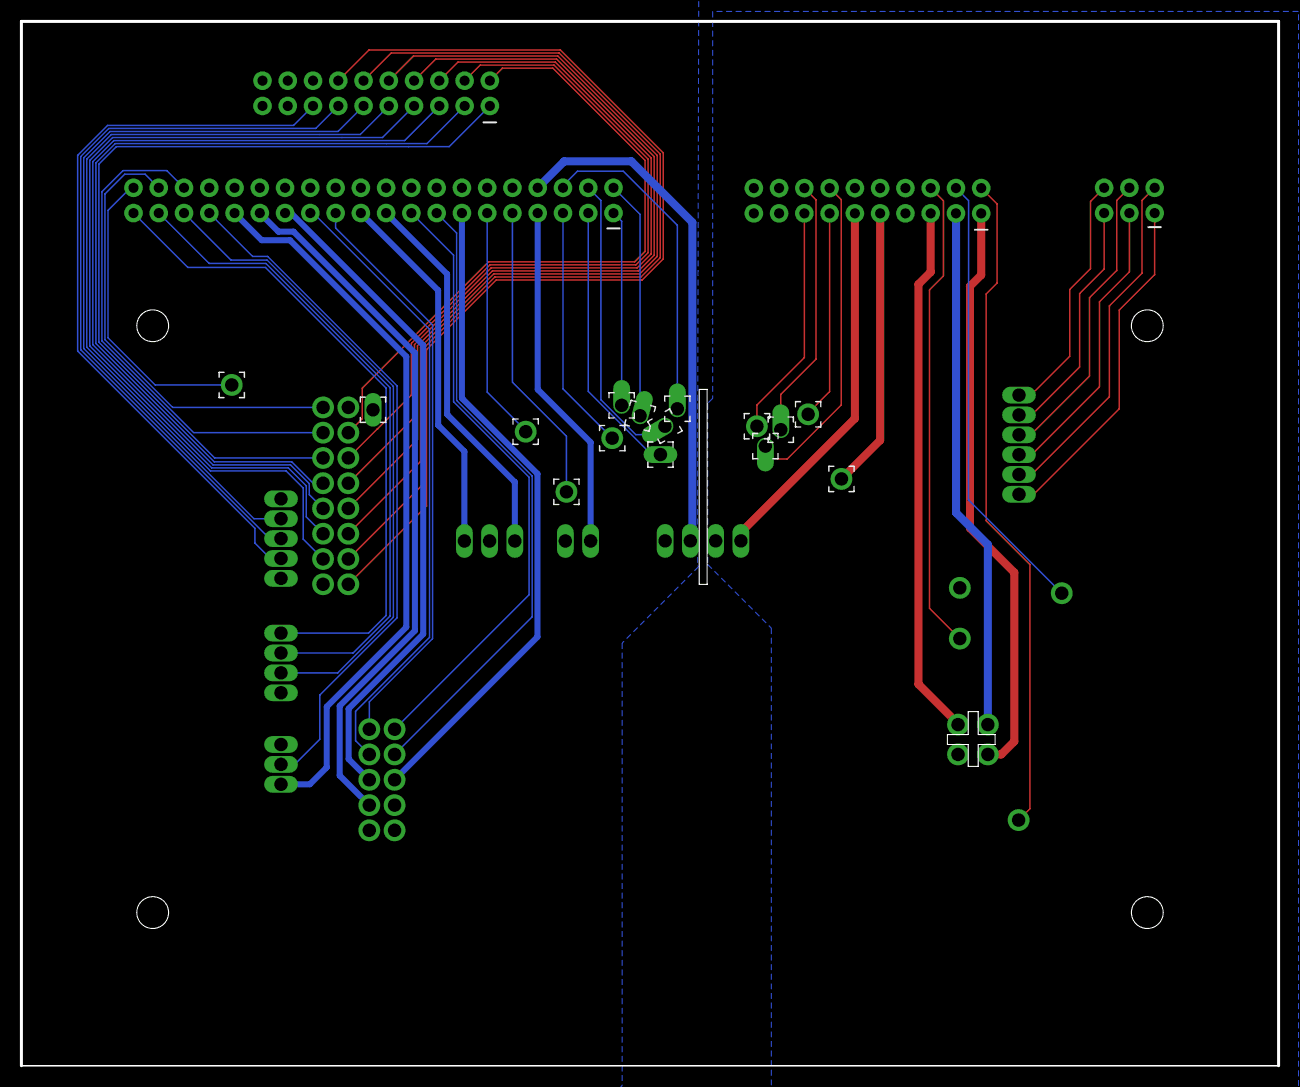
[picture p9: board test_board.brd from below]

Board: 2 copper layers, 126.4 x 105.0 mm, 81 parts (15 on the bottom side), 59 nets.
