mastrogippo/Prism-Test-Board/(notices)

Notices in the files:
SW/Low_voltage_side/src/main.cpp:
This program is free software: you can redistribute it and/or modify it under
the terms of the GNU General Public License as published by the Free Software
parts and their libraries:
SparkFun-Connectors: Licensing: Creative Commons ShareAlike 4.0 International - https://creativecommons.org/licenses/by-sa/4.0
